timbitss/reflow-oven-controller/images/IR-Convection-Reflow-Profile-IPC-JEDEC-J-STD-020C.jpg-nggid0226-ngg0dyn-0x0x100-00f0w010c010r110f110r010t010.jpg

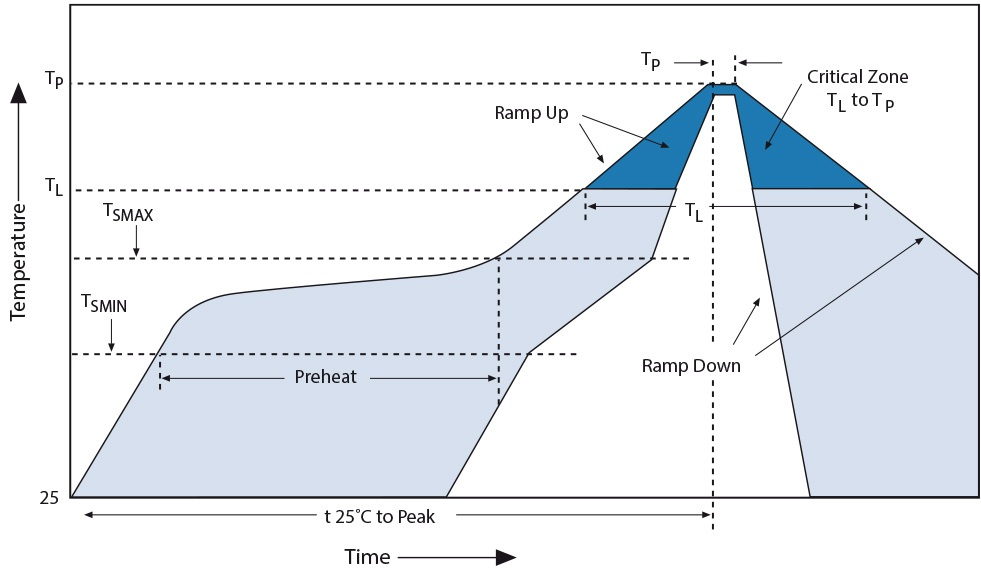
images/IR-Convection-Reflow-Profile-IPC-JEDEC-J-STD-020C.jpg-nggid0226-ngg0dyn-0x0x100-00f0w010c010r110f110r010t010.jpg
