timbitss/reflow-oven-controller/images/reflow_dependencies.png

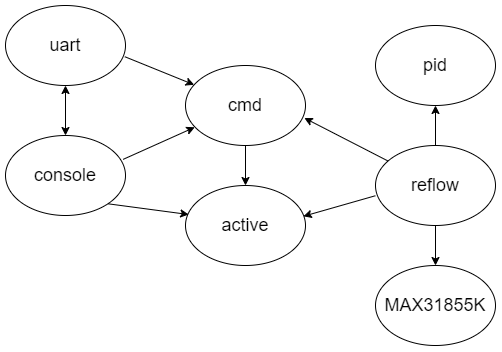
images/reflow_dependencies.png
