timbitss/reflow-oven-controller/images/reflow_state_diagram.png

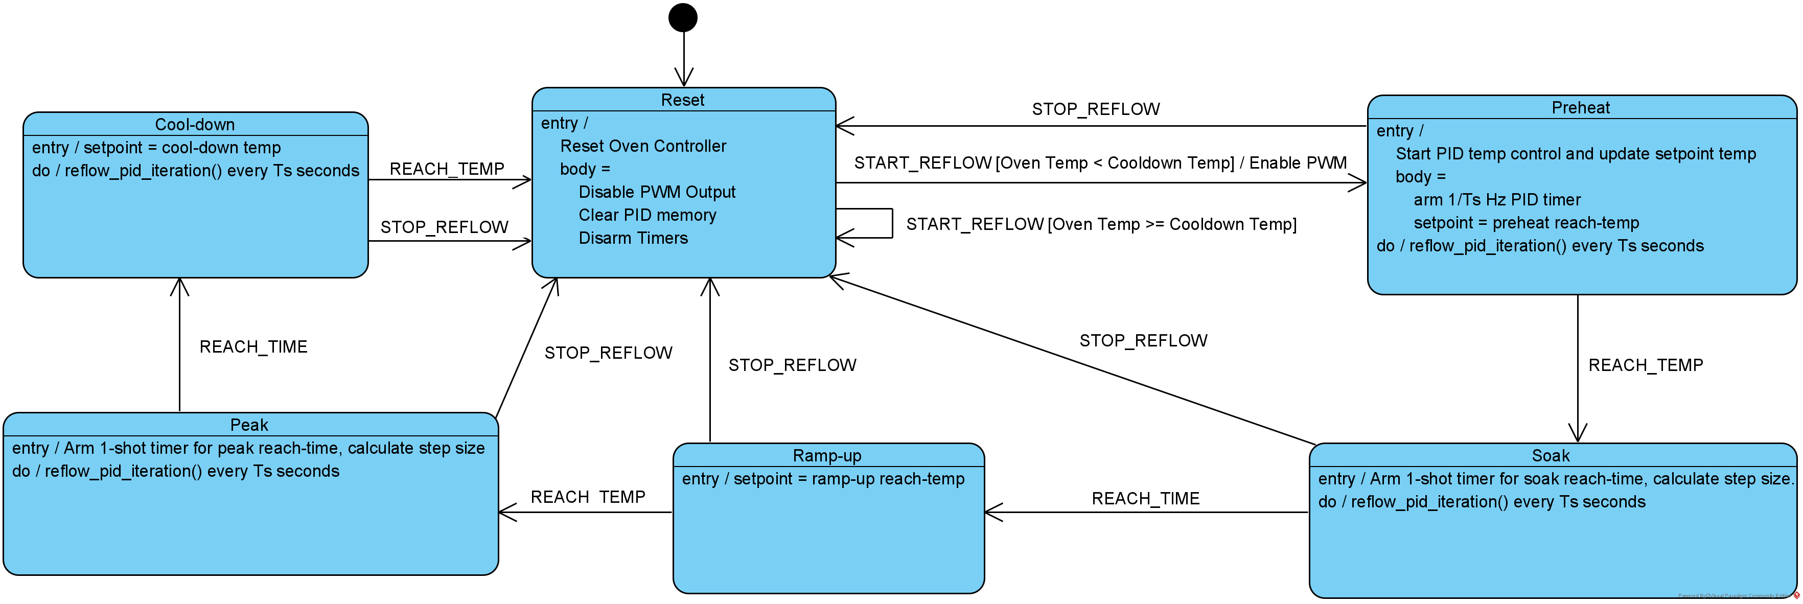
images/reflow_state_diagram.png
