timbitss/reflow-oven-controller/Core/Src/main.c

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
/* Includes ------------------------------------------------------------------*/
#include "main.h"
#include "cmsis_os.h"

/* USER CODE BEGIN Includes */
#include "string.h"
#include "printf.h"
#include "uart.h"
#include "console.h"
#include "cmd.h"
#include "log.h"
#include "reflow.h"
/* USER CODE END Includes */

SPI_HandleTypeDef hspi2;

TIM_HandleTypeDef htim3;

/* Definitions for defaultTask */
osThreadId_t defaultTaskHandle;
const osThreadAttr_t defaultTask_attributes = {
    .name = "defaultTask",
    .stack_size = 512 * 4,
    .priority = (osPriority_t)osPriorityNormal,
};
/* USER CODE BEGIN PV */

static const Reflow_cfg_t reflow_cfg =
    {
        .pwm_timer_handle = &htim3,   // PWM Timer handle.
        .pwm_channel = TIM_CHANNEL_1, // PWM Timer channel.
        .max_cfg = {                  // MAX31855K Thermocouple IC configuration structure.
                    .hspi = &hspi2,
                    .max_cs_port = MAX_CS_GPIO_Port,
                    .max_cs_pin = MAX_CS_Pin}};
/* USER CODE END PV */

void SystemClock_Config(void);
static void MX_GPIO_Init(void);
static void MX_USART2_UART_Init(void);
static void MX_TIM3_Init(void);
static void MX_SPI2_Init(void);
void StartDefaultTask(void *argument);

/**
  * @brief  The application entry point.
  * @retval int
  */
int main(void)
{
    /* MCU Configuration--------------------------------------------------------*/

    /* Reset of all peripherals, Initializes the Flash interface and the Systick. */
    HAL_Init();

    /* Configure the system clock */
    SystemClock_Config();

    /* Initialize all configured peripherals */
    MX_GPIO_Init();
    MX_USART2_UART_Init();
    MX_TIM3_Init();
    MX_SPI2_Init();
    /* USER CODE BEGIN 2 */
    uart_config_t uart_cfg = {.uart_reg_base = USART2, .irq_num = USART2_IRQn};
    uart_init(&uart_cfg);
    uart_start();
    HAL_GPIO_WritePin(LD2_GPIO_Port, LD2_Pin, GPIO_PIN_SET);
    /* USER CODE END 2 */

    /* Init scheduler */
    osKernelInitialize();

    /* USER CODE BEGIN RTOS_MUTEX */
    /* add mutexes, ... */
    /* USER CODE END RTOS_MUTEX */

    /* USER CODE BEGIN RTOS_SEMAPHORES */
    /* add semaphores, ... */
    /* USER CODE END RTOS_SEMAPHORES */

    /* USER CODE BEGIN RTOS_TIMERS */
    /* start timers, add new ones, ... */
    /* USER CODE END RTOS_TIMERS */

    /* USER CODE BEGIN RTOS_QUEUES */
    /* add queues, ... */
    /* USER CODE END RTOS_QUEUES */

    /* Create the thread(s) */
    /* creation of defaultTask */
    defaultTaskHandle = osThreadNew(StartDefaultTask, NULL, &defaultTask_attributes);

    /* USER CODE BEGIN RTOS_THREADS */
    /* add threads, ... */
    /* USER CODE END RTOS_THREADS */

    /* USER CODE BEGIN RTOS_EVENTS */
    /* add events, ... */
    /* USER CODE END RTOS_EVENTS */

    /* Start scheduler */
    osKernelStart();

    /* We should never get here as control is now taken by the scheduler */
    /* Infinite loop */
    /* USER CODE BEGIN WHILE */
    while (1)
    {
        /* USER CODE END WHILE */

        /* USER CODE BEGIN 3 */
    }
    /* USER CODE END 3 */
}

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
/* USER CODE BEGIN Header_StartDefaultTask */
/**
  * @brief  Function implementing the defaultTask thread.
  * @param  argument: Not used
  * @retval None
  */
/* USER CODE END Header_StartDefaultTask */
void StartDefaultTask(void *argument)
{
    /* USER CODE BEGIN 5 */

    console_init();
    cmd_init();
    log_init();

    reflow_init(&reflow_cfg);

    console_start();
    cmd_start();
    reflow_start();

    osThreadTerminate(defaultTaskHandle);
    /* Infinite loop */
    for (;;)
    {
        osDelay(1);
    }
    /* USER CODE END 5 */
}

/**
  * @brief  Period elapsed callback in non blocking mode
  * @note   This function is called  when TIM7 interrupt took place, inside
  * HAL_TIM_IRQHandler(). It makes a direct call to HAL_IncTick() to increment
  * a global variable "uwTick" used as application time base.
  * @param  htim : TIM handle
  * @retval None
  */
void HAL_TIM_PeriodElapsedCallback(TIM_HandleTypeDef *htim)
{
    if (htim->Instance == TIM7)
    {
        HAL_IncTick();
    }
}

/**
  * @brief  This function is executed in case of error occurrence.
  * @retval None
  */
void Error_Handler(void)
{
    /* USER CODE BEGIN Error_Handler_Debug */
    /* User can add his own implementation to report the HAL error return state */
    __disable_irq();
    while (1)
    {
    }
    /* USER CODE END Error_Handler_Debug */
}

#ifdef USE_FULL_ASSERT
/**
  * @brief  Reports the name of the source file and the source line number
  *         where the assert_param error has occurred.
  * @param  file: pointer to the source file name
  * @param  line: assert_param error line source number
  * @retval None
  */
void assert_failed(uint8_t *file, uint32_t line)
{
    /* USER CODE BEGIN 6 */
    /* User can add his own implementation to report the file name and line number,
     ex: printf("Wrong parameters value: file %s on line %d\r\n", file, line) */
    /* USER CODE END 6 */
}
#endif /* USE_FULL_ASSERT */

/************************ (C) COPYRIGHT STMicroelectronics *****END OF FILE****/
