timbitss/reflow-oven-controller/reflow_oven_controller.ioc

Mcu.UserName=STM32L476RGTx
PC13.GPIO_Label=B1 [Blue PushButton]
PC3.Signal=SPI2_MOSI
PC4.GPIO_Label=MAX_CS
PA6.Signal=S_TIM3_CH1
PA2.GPIO_Label=USART_TX
PA3.Signal=USART2_RX
PC13.Signal=GPXTI13
PC2.Signal=SPI2_MISO
PC4.Signal=GPIO_Output
PB10.Signal=SPI2_SCK
PA5.Signal=GPIO_Output
PA2.Signal=USART2_TX
PA5.GPIO_Label=LD2 [green Led]
PA3.GPIO_Label=USART_RX
